Hadjubuntu/breeze-design/UAV/03_Conception/sc_board_v1.jpg

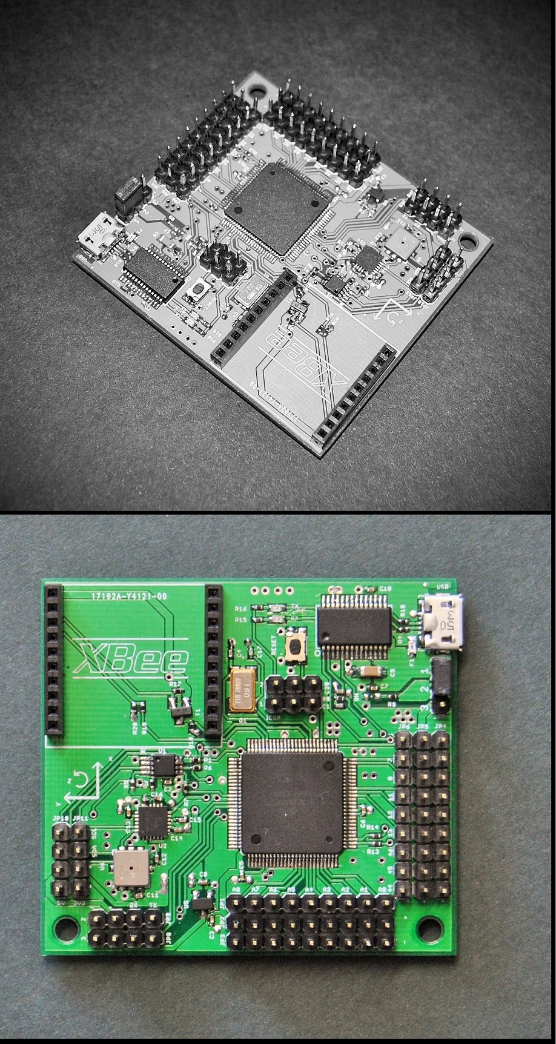
UAV/03_Conception/sc_board_v1.jpg
