Hadjubuntu/breeze-design/UAV/03_Conception/Board_v1/Breeze BoM.xlsx

Qty | Value | Package | Parts | Description
6 | 0.1uF | C0402 | C7, C10, C11, C12, C14, C20 | CERAMIC CAPACITOR
2 | 100nF | C0402 | C5, C6 | CERAMIC CAPACITOR
1 | 10nF | C0402 | C16 | CERAMIC CAPACITOR
1 | 10uF | SMC_A | C9 | TANTALUM CAPACITOR
4 | 1uF | C0402 | C2, C3, C8, C15 | CERAMIC CAPACITOR
1 | 2.2nF | C0402 | C13 | CERAMIC CAPACITOR
1 | 22pF | C0402 | C1 | CERAMIC CAPACITOR
2 | 33pF | C0402 | C4, C17 | CERAMIC CAPACITOR
4 | 10Kohm | C0402 | R8, R17, R18, R19 | RESISTOR 1% or 5%
5 | 1Kohm | C0402 | R9, R13, R14, R15, R16 | RESISTOR 1% or 5%
1 | 200Kohm | C0402 | R1 | RESISTOR 1% or 5%
1 | 20Kohm | C0402 | R20 | RESISTOR 1% or 5%
2 | 27ohm | C0402 | R4, R10 | RESISTOR 1% or 5%
4 | 4.7Kohm | C0402 | R2, R5, R6, R7 | RESISTOR 1% or 5%
1 | 16MHz Crystal | CTS406 | Q1 | Mouser reff: 815-ABMM2-16-E2T
3 | LED | C0603 | ON, RX, TX | LED
1 | ATMEGA2560-16AU | TQFP100 | U3
1 | BMP085 | LCC8 | U6
1 | BSS138 | SOT23 | T1
1 | MCP1703T-3302E/CB | SOT23 | U5 | 3V3 LDO
1 | MPU9150 | QFN24 | U2
1 | FT232RL | SSOP28 | U4
1 | PCA9306DP | TSSOP8 | U1
1 | PTC0603 | C0603 | F1 | 500mA resettable fuse
1 | KMR223 G LFG | KMR2 | SW1 | http://www.ck-components.com/kmr-2/tactile,10572,en.html
1 | USB MOLEX 47346-0001 |  | USB | 5 pos micro USB R/A SMD
