Hadjubuntu/breeze-design/UAV/03_Conception/Board_v1/Breeze UAV.brd

## EAGLE design UAV/03_Conception/Board_v1/Breeze UAV.brd (2015-05-16)

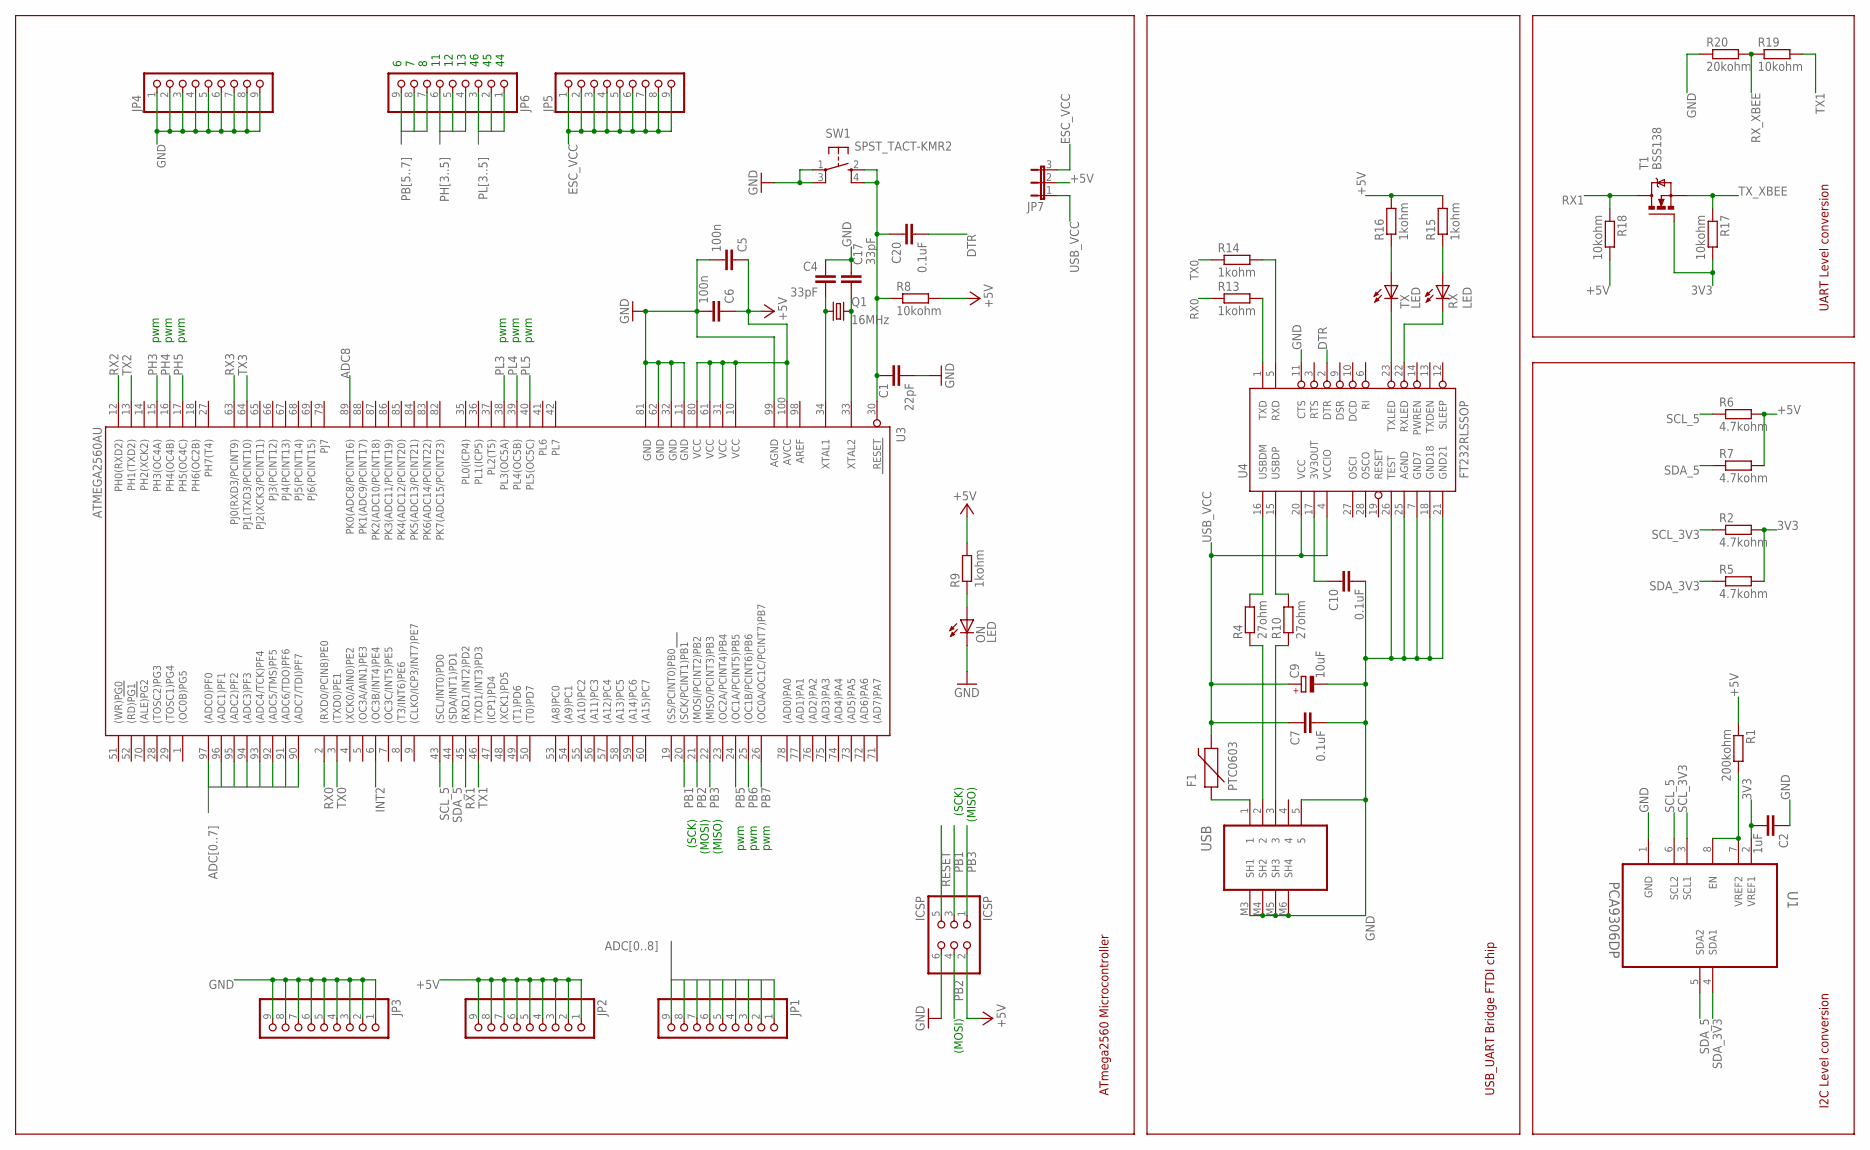
[picture p2: schematic Breeze UAV.sch, sheet 1]

Parts:
C1: 22pF; C0402
C2: 1uF; C0402
C4, C17: 33pF; C0402
C5, C6: 100n; C0402
C7, C10, C20: 0.1uF; C0402
C9: 10uF; SMC_A
F1: PTC0603; 0603
ICSP: ICSP; 2X03
JP1, JP2, JP3, JP4, JP5, JP6: PINHD-1X9; 1X09
JP7: JP2E; JP2
ON: LED; CHIPLED_0603
Q1: 16MHz; CTS406
R1: 200kohm; R0402
R2, R5, R6, R7: 4.7kohm; R0402
R4, R10: 27ohm; R0402
R8, R17, R18, R19: 10kohm; R0402
R9, R13, R14, R15, R16: 1kohm; R0402
R20: 20kohm; R0402
RX: LED; CHIPLED_0603
SW1: SPST_TACT-KMR2; KMR2
T1: BSS138; SOT23
TX: LED; CHIPLED_0603
U1: PCA9306DP; SOP65P490X110-8N
U3: ATMEGA2560AU; TQFP100
U4: FT232RLSSOP; SSOP28DB
USB: 47346-0001; MOLEX_47346-0001

Connections:
3V3: C2.2, R2.2, R5.2, R17.2, T1.1 (G), U1.2 (VREF1); also elsewhere on the board
+5V: C5.1, C6.1, ICSP.2, JP2.1, JP2.2, JP2.3, JP2.4, JP2.5, JP2.6, JP2.7, JP2.8, JP2.9, JP7.2, R1.1, R6.2, R7.2, R8.2, R9.2, R15.2, R16.2, R18.2, U3.10 (VCC), U3.31 (VCC1), U3.61 (VCC2), U3.80 (VCC3), U3.100 (AVCC); also elsewhere on the board
ADC0: JP1.1, U3.97 ((ADC0)PF0)
ADC1: JP1.2, U3.96 ((ADC1)PF1)
ADC2: JP1.3, U3.95 ((ADC2)PF2)
ADC3: JP1.4, U3.94 ((ADC3)PF3)
ADC4: JP1.5, U3.93 ((ADC4/TCK)PF4)
ADC5: JP1.6, U3.92 ((ADC5/TMS)PF5)
ADC6: JP1.7, U3.91 ((ADC6/TDO)PF6)
ADC7: JP1.8, U3.90 ((ADC7/TDI)PF7)
ADC8: JP1.9, U3.89 (PK0(ADC8/PCINT16))
DTR: C20.2, U4.2 (DTR)
ESC_VCC: JP5.1, JP5.2, JP5.3, JP5.4, JP5.5, JP5.6, JP5.7, JP5.8, JP5.9, JP7.3
GND: C1.2, C2.1, C4.1, C5.2, C6.2, C7.2, C9.-, C10.2, C17.2, ICSP.6, JP3.1, JP3.2, JP3.3, JP3.4, JP3.5, JP3.6, JP3.7, JP3.8, JP3.9, JP4.1, JP4.2, JP4.3, JP4.4, JP4.5, JP4.6, JP4.7, JP4.8, JP4.9, ON.C, R20.1, SW1.1, SW1.3 (P1), U1.1 (GND), U3.11 (GND), U3.32 (GND1), U3.62 (GND2), U3.81 (GND3), U3.99 (AGND), U4.7 (GND7), U4.11 (CTS), U4.18 (GND18), U4.21 (GND21), U4.25 (AGND), U4.26 (TEST), USB.5, USB.M3 (SH1), USB.M4 (SH2), USB.M5 (SH3), USB.M6 (SH4); also elsewhere on the board
INT2: U3.6 ((OC3B/INT4)PE4); also elsewhere on the board
M8RXD: R13.2, U4.1 (TXD)
unnamed: R1.2, U1.7 (VREF2), U1.8 (EN)
unnamed: ON.A, R9.1
unnamed: R4.1, USB.2
unnamed: R10.1, USB.3
unnamed: R14.2, U4.5 (RXD)
unnamed: R4.2, U4.16 (USBDM)
unnamed: R10.2, U4.15 (USBDP)
unnamed: R16.1, TX.A
unnamed: R15.1, RX.A
unnamed: RX.C, U4.22 (RXLED)
unnamed: C10.1, U4.17 (3V3OUT)
PB1: ICSP.3, U3.20 ((SCK/PCINT1)PB1)
PB2: ICSP.4, U3.21 ((MOSI/PCINT2)PB2)
PB3: ICSP.1, U3.22 ((MISO/PCINT3)PB3)
PB5: JP6.7, U3.24 ((OC1A/PCINT5)PB5)
PB6: JP6.8, U3.25 ((OC1B/PCINT6)PB6)
PB7: JP6.9, U3.26 ((OC0A/OC1C/PCINT7)PB7)
PH3: JP6.4, U3.15 (PH3(OC4A))
PH4: JP6.5, U3.16 (PH4(OC4B))
PH5: JP6.6, U3.17 (PH5(OC4C))
PL3: JP6.3, U3.38 (PL3(OC5A))
PL4: JP6.2, U3.39 (PL4(OC5B))
PL5: JP6.1, U3.40 (PL5(OC5C))
RESET: C1.1, C20.1, ICSP.5, R8.1, SW1.2 (S), SW1.4 (S1), U3.30 (RESET)
RX0: R13.1, U3.2 ((RXD0/PCIN8)PE0)
RX1: R18.1, T1.3 (D), U3.45 ((RXD1/INT2)PD2)
RX2: U3.12 (PH0(RXD2)); also elsewhere on the board
RX3: U3.63 (PJ0(RXD3/PCINT9)); also elsewhere on the board
RX_XBEE: R19.1, R20.2; also elsewhere on the board
SCL_3V3: R2.1, U1.3 (SCL1); also elsewhere on the board
SCL_5: R6.1, U1.6 (SCL2), U3.43 ((SCL/INT0)PD0); also elsewhere on the board
SDA_3V3: R5.1, U1.4 (SDA1); also elsewhere on the board
SDA_5: R7.1, U1.5 (SDA2), U3.44 ((SDA/INT1)PD1); also elsewhere on the board
TX: TX.C, U4.23 (TXLED)
TX0: R14.1, U3.3 ((TXD0)PE1)
TX1: R19.2, U3.46 ((TXD1/INT3)PD3)
TX2: U3.13 (PH1(TXD2)); also elsewhere on the board
TX3: U3.64 (PJ1(TXD3/PCINT10)); also elsewhere on the board
TX_XBEE: R17.1, T1.2 (S); also elsewhere on the board
USB_VCC: C7.1, C9.+, F1.2, JP7.1, U4.4 (VCCIO), U4.20 (VCC)
VUSB: F1.1, USB.1
XTAL1: C4.2, Q1.1, U3.34 (XTAL1)
XTAL2: C17.1, Q1.3 (2), U3.33 (XTAL2)

Notes on the sheet:
(SCK)
(MISO)
(MOSI)
pwm
I2C Level conversion
UART Level conversion
USB_UART Bridge FTDI chip
ATmega2560 Microcontroller

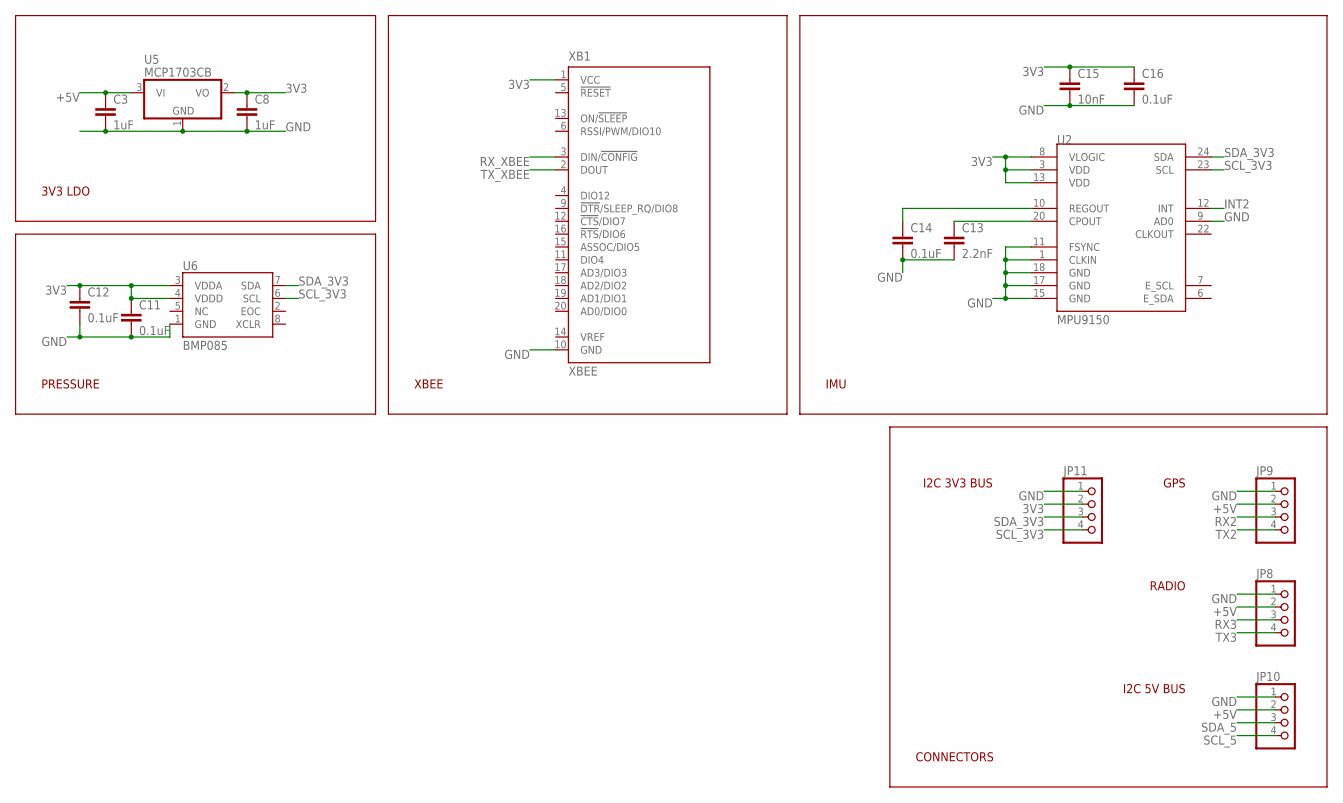
[picture p3: schematic Breeze UAV.sch, sheet 2]

Parts:
C3, C8: 1uF; C0402
C11, C12, C14, C16: 0.1uF; C0402
C13: 2.2nF; C0402
C15: 10nF; C0402
JP8, JP9, JP10, JP11: PINHD-1X4; 1X04
U2: MPU9150; QFN-24-NP
U5: MCP1703CB; SOT23
U6: BMP085
XB1: XBEE

Connections:
3V3: C8.1, C11.1, C12.1, C15.1, C16.1, JP11.2, U2.3 (VDD), U2.8 (VLOGIC), U2.13 (VDD), U5.2 (VO), U6.3 (VDDA), U6.4 (VDDD), XB1.1 (VCC); also elsewhere on the board
+5V: C3.1, JP8.2, JP9.2, JP10.2, U5.3 (VI); also elsewhere on the board
GND: C3.2, C8.2, C11.2, C12.2, C13.2, C14.2, C15.2, C16.2, JP8.1, JP9.1, JP10.1, JP11.1, U2.1 (CLKIN), U2.9 (AD0), U2.11 (FSYNC), U2.15 (GND), U2.17 (GND), U2.18 (GND), U5.1 (GND), U6.1 (GND), XB1.10 (GND); also elsewhere on the board
INT2: U2.12 (INT); also elsewhere on the board
unnamed: C13.1, U2.20 (CPOUT)
unnamed: C14.1, U2.10 (REGOUT)
RX2: JP9.3; also elsewhere on the board
RX3: JP8.3; also elsewhere on the board
RX_XBEE: XB1.3 (DIN/!CONFIG); also elsewhere on the board
SCL_3V3: JP11.4, U2.23 (SCL), U6.6 (SCL); also elsewhere on the board
SCL_5: JP10.4; also elsewhere on the board
SDA_3V3: JP11.3, U2.24 (SDA), U6.7 (SDA); also elsewhere on the board
SDA_5: JP10.3; also elsewhere on the board
TX2: JP9.4; also elsewhere on the board
TX3: JP8.4; also elsewhere on the board
TX_XBEE: XB1.2 (DOUT); also elsewhere on the board

Notes on the sheet:
3V3 LDO
PRESSURE
XBEE
IMU
CONNECTORS
RADIO
GPS
I2C 5V BUS
I2C 3V3 BUS

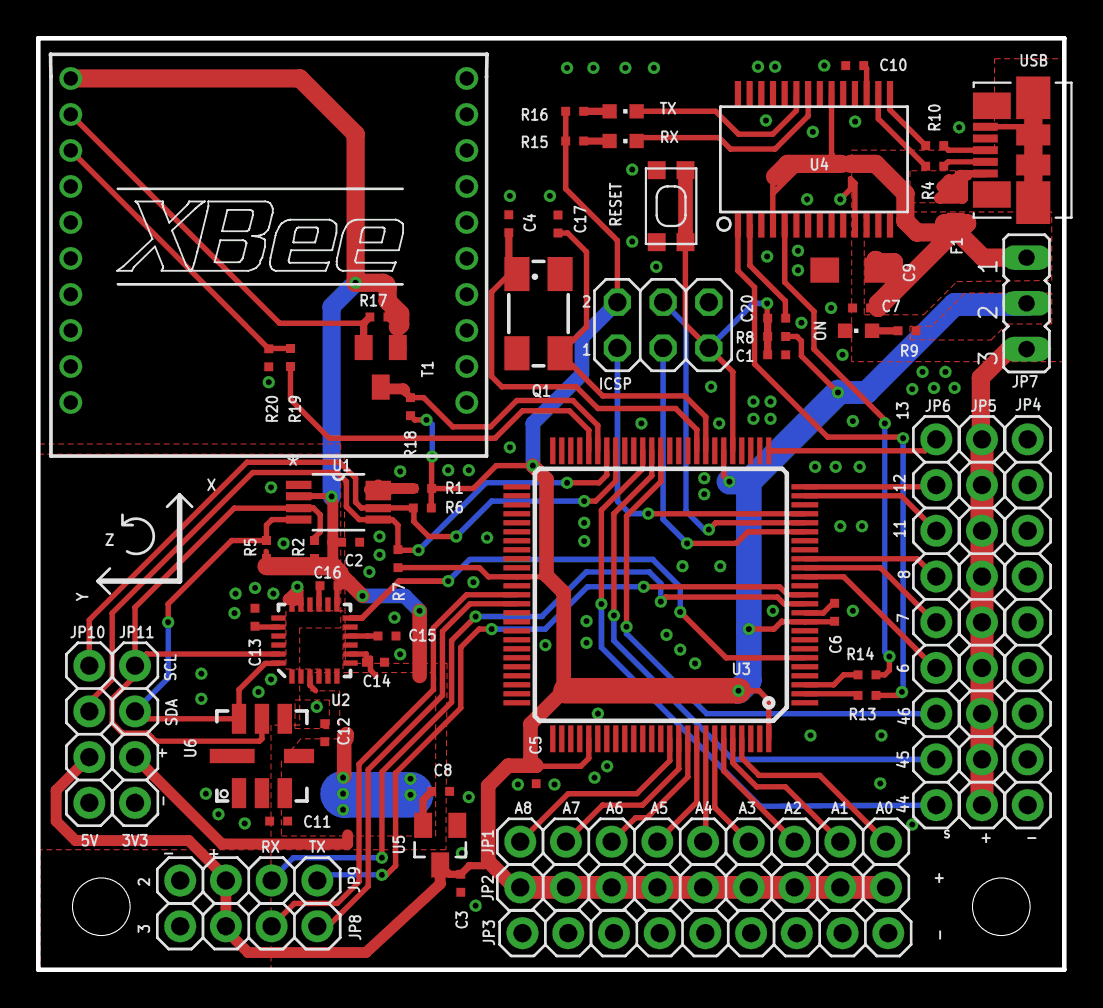
[picture p4: board Breeze UAV.brd from above]

Board: 2 copper layers, 57.0 x 51.7 mm, 62 parts (0 on the bottom side), 61 nets.
